open-ephys/ECP5U85-BSE-USB/pcb/images/PXL_20230309_210807720.jpg

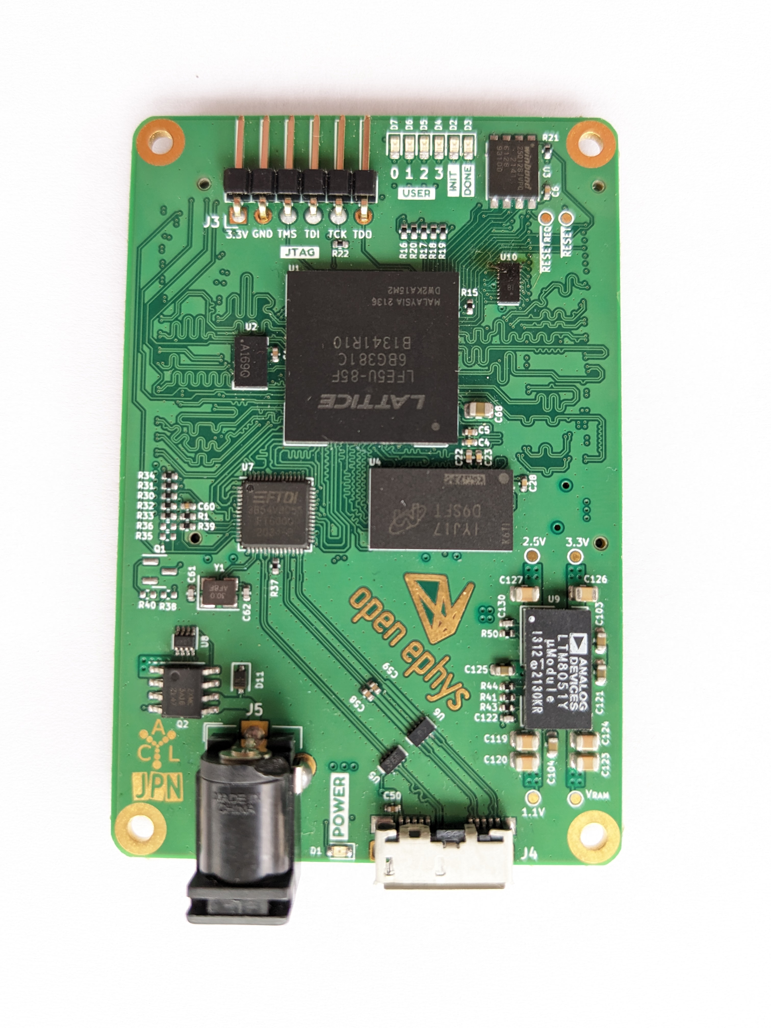
pcb/images/PXL_20230309_210807720.jpg
