open-ephys/ECP5U85-BSE-USB/README.md

# Open Ephys ECP5U85-BSE-USB Development Board

- Lattice ECP5U85 FPGA
- Samtec BSE GPIO strip connectors
- USB3.0 link to host computer (max 200MB/s)

ECP5U85-BSE-USB Rev. A front and back views ECP5U85-BSE-USB Rev. A
