open-ephys/ECP5U85-BSE-USB/pcb/models/PJ-102AH.STEP

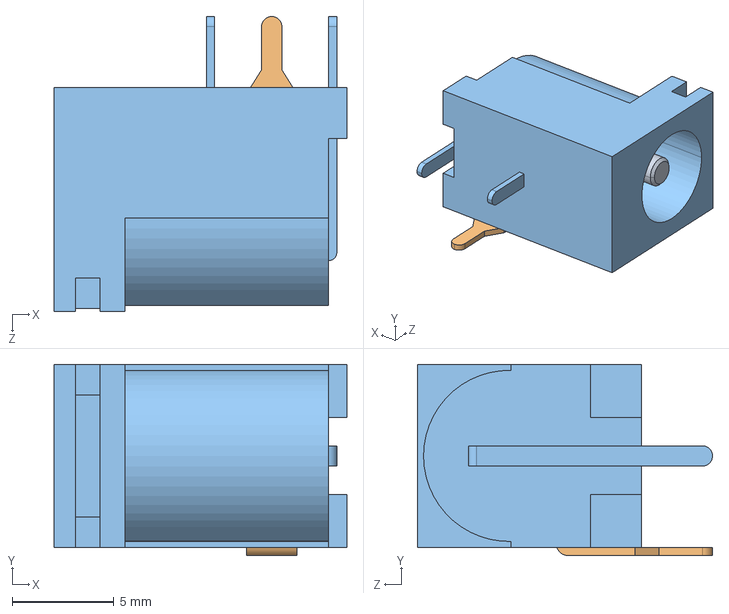
[picture p3: CAD file, 2022-03-02]
pcb/models/PJ-102AH.STEP
14.4 x 9.40 x 14.5 mm
