open-ephys/ECP5U85-BSE-USB/test-pcb/ecp5u85-bse-usb_io-tester.pdf

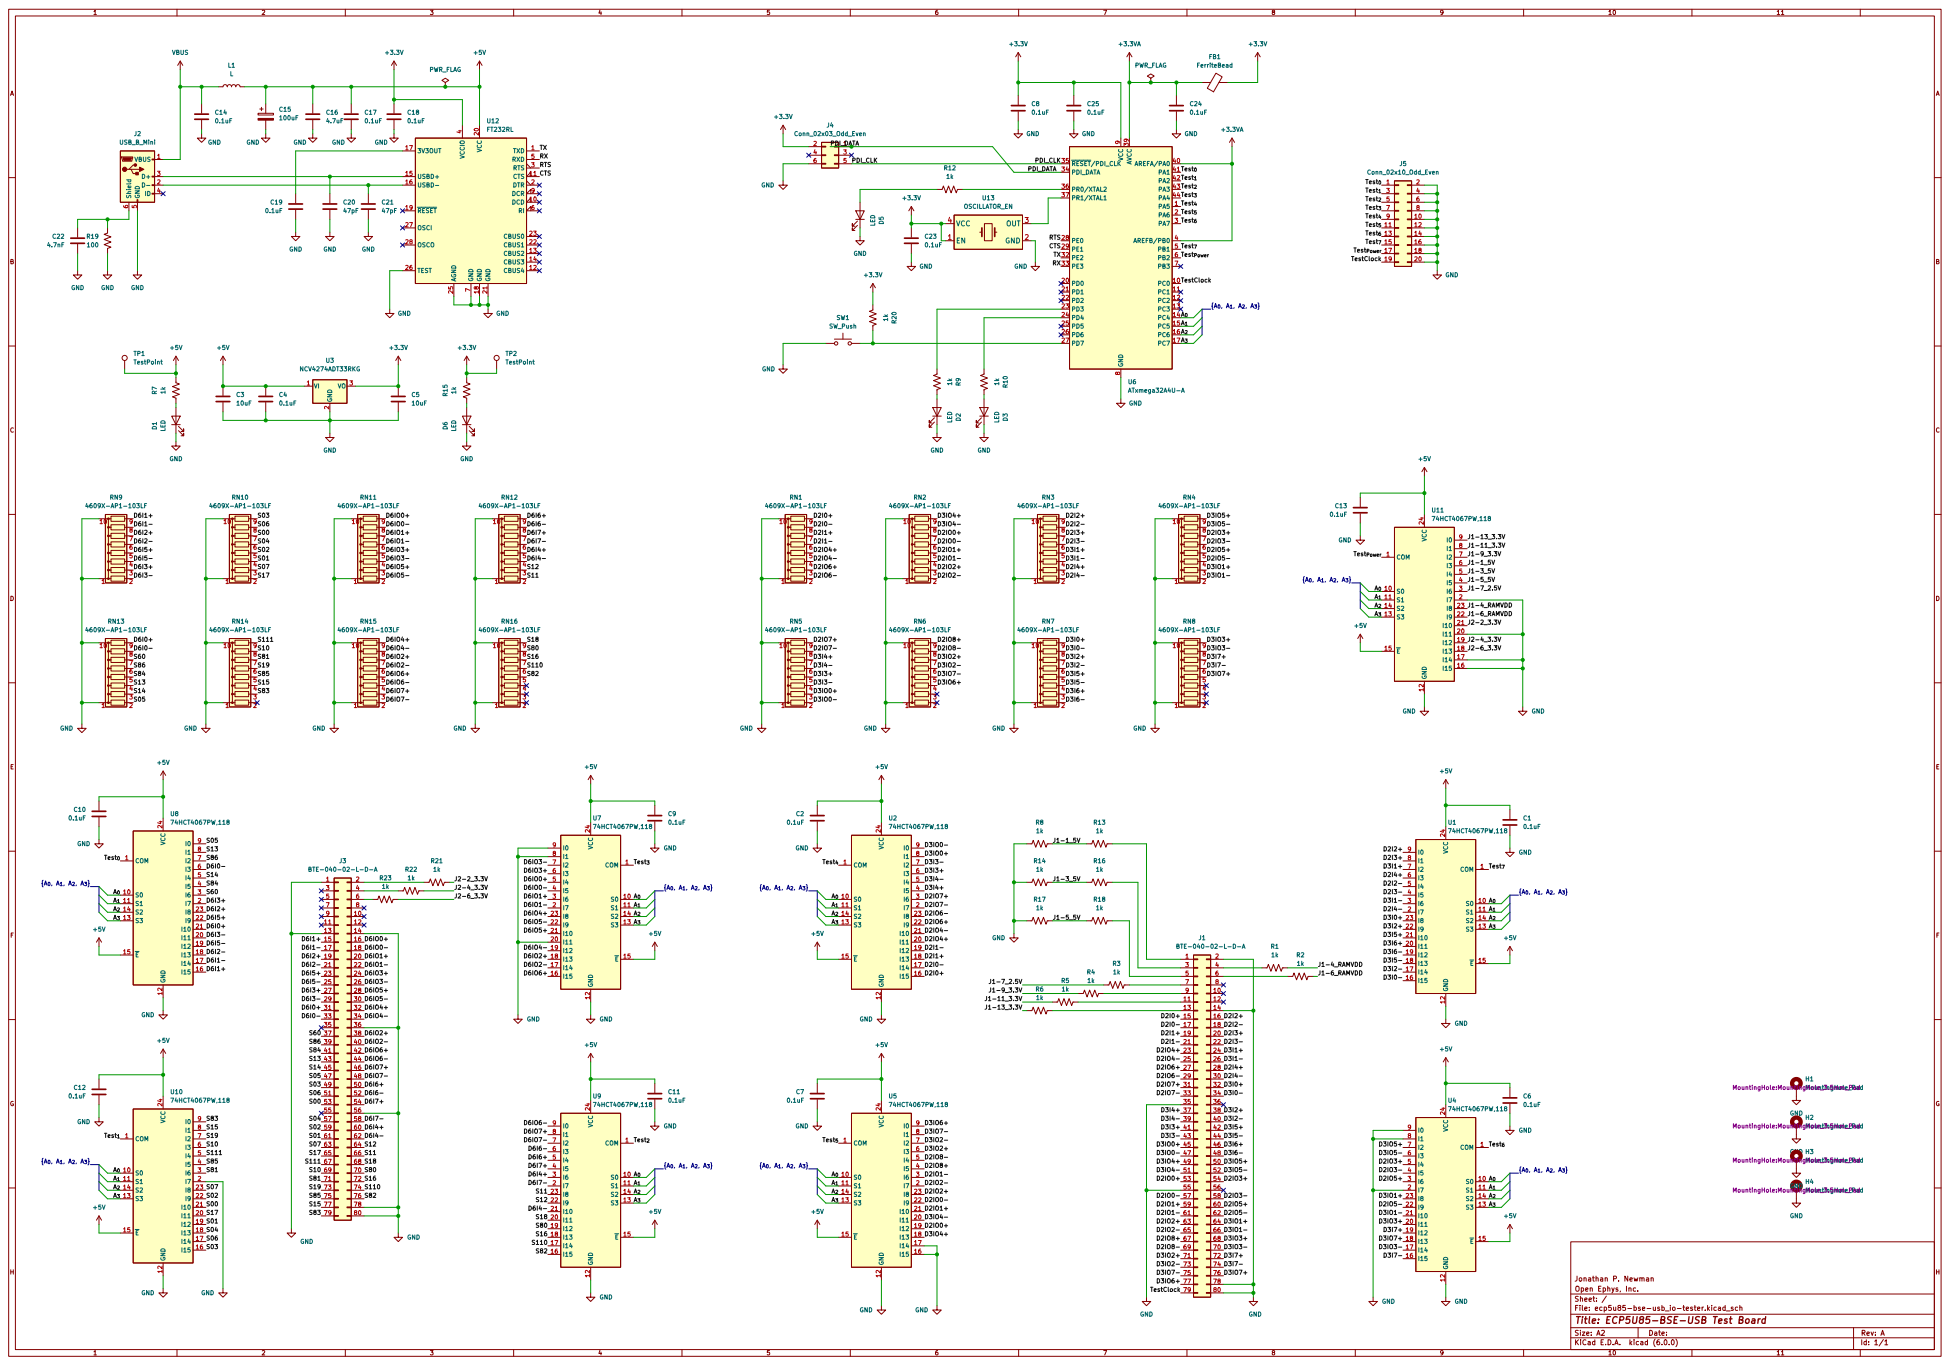
[picture p4: page 1]

RTS
Test_{7} TestClock Test_{Power} RX CTS

File: ecp5u85-bse-usb_io-tester.kicad_sch Sheet: / Open Ephys, Inc. Jonathan P. Newman

Id: 1/1 Title: ECP5U85-BSE-USB Test Board
