open-ephys/ECP5U85-BSE-USB/pcb/ecp5u85-bse-usb.pdf

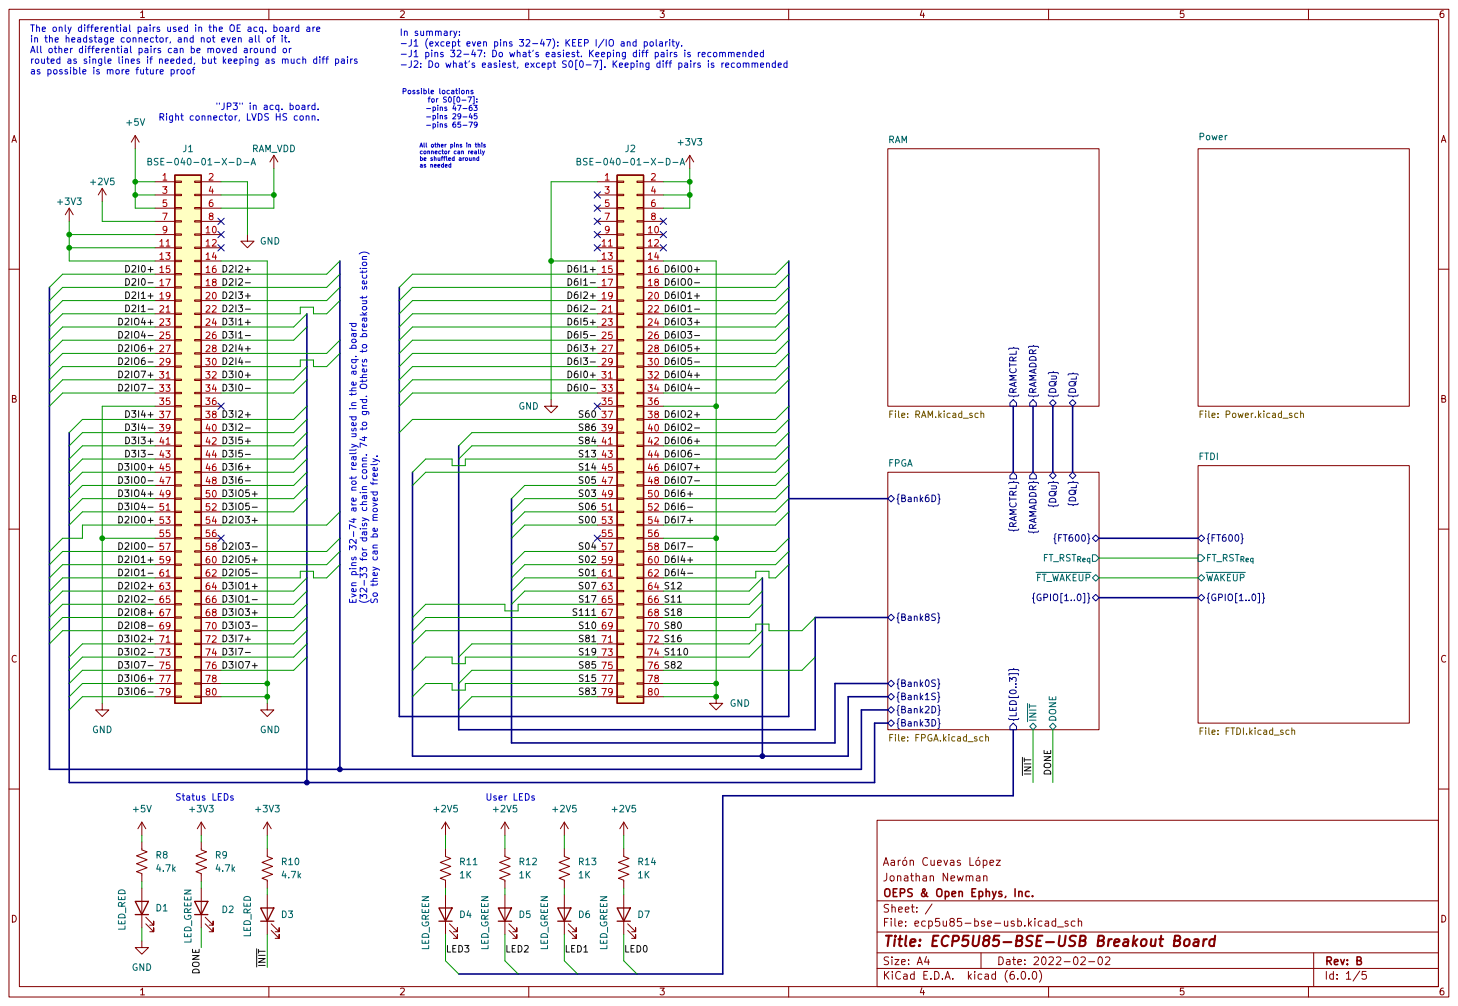
[picture p5: page 1]

The only differential pairs used in the OE acq. board are
in the headstage connector, and not even all of it.
All other differential pairs can be moved around or
routed as single lines if needed, but keeping as much diff pairs
as possible is more future proof

In summary:
-J1 (except even pins 32-47): KEEP I/IO and polarity.
-J1 pins 32-47: Do what's easiest. Keeping diff pairs is recommended
-J2: Do what's easiest, except S0[0-7]. Keeping diff pairs is recommended

All other pins in this

{GPIO[1..0]} FTDI File: FTDI.kicad_sch R9

File: ecp5u85-bse-usb.kicad_sch Sheet: / OEPS & Open Ephys, Inc. Jonathan Newman

Id: 1/5 Title: ECP5U85-BSE-USB Breakout Board

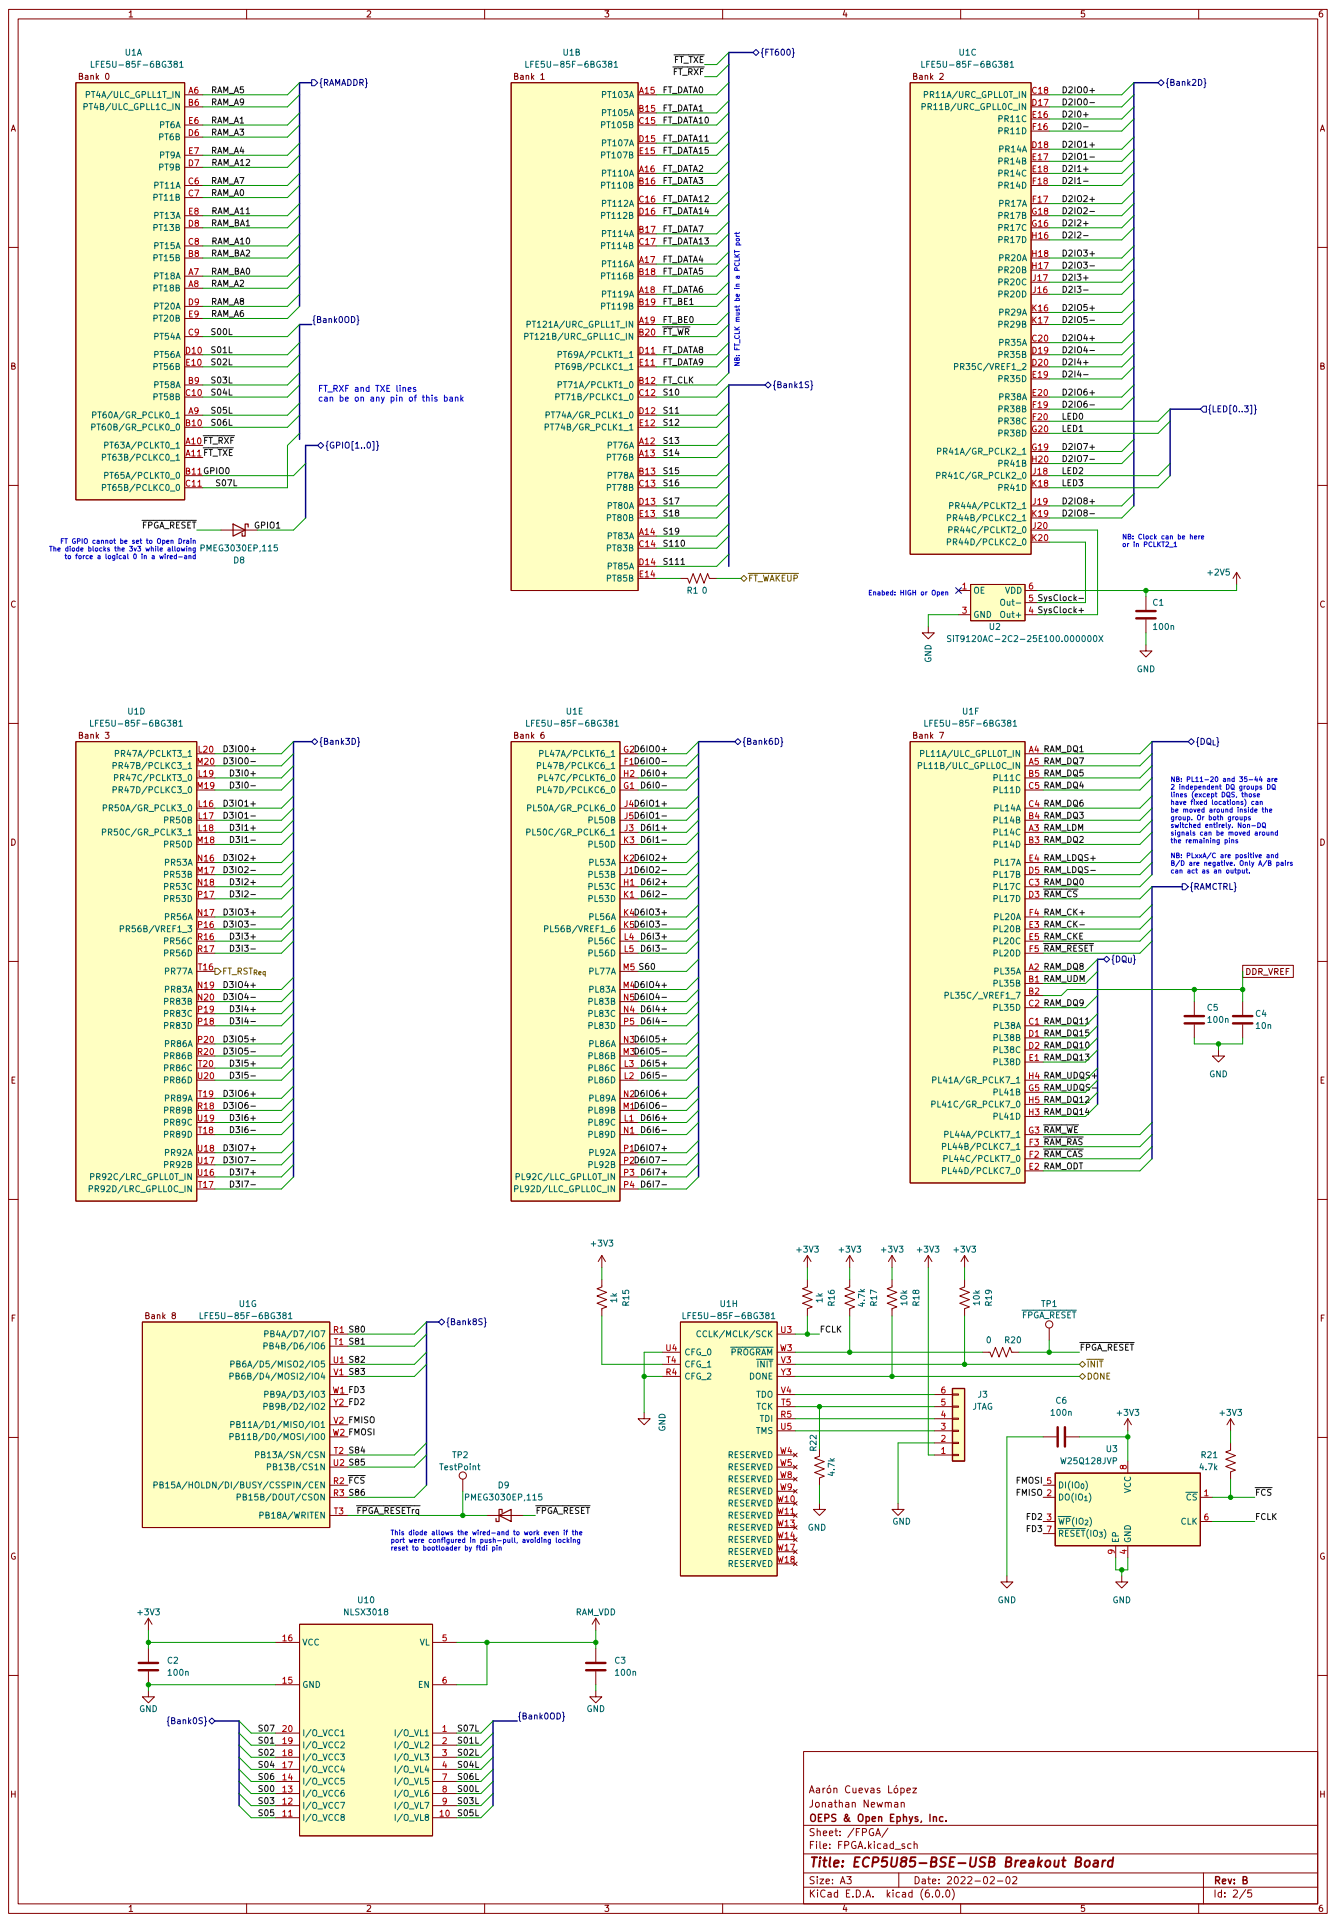
[picture p6: page 2]

Enabed: HIGH or Open FT_RXF and TXE lines
can be on any pin of this bank

or in PCLKT2_1 FT GPIO cannot be set to Open Drain The diode blocks the 3v3 while allowing

NB: Clock can be here

2 independent DQ groups DQ
lines (except DQS, those
have fixed locations) can
be moved around inside the
group. Or both groups
switched entirely. Non-DQ
signals can be moved around
the remaining pins

NB: PLxxA/C are positive and B/D are negative. Only A/B pairs

can act as an output.
{RAMCTRL}

4 DI(IO_{0}) 5 CLK 6 ~{RESET}(IO_{3}) 7 VCC

This diode allows the wired-and to work even if the
port were configured in push-pull, avoiding locking
reset to bootloader by ftdi pin

File: FPGA.kicad_sch Sheet: /FPGA/ OEPS & Open Ephys, Inc. Jonathan Newman

Id: 2/5 Title: ECP5U85-BSE-USB Breakout Board

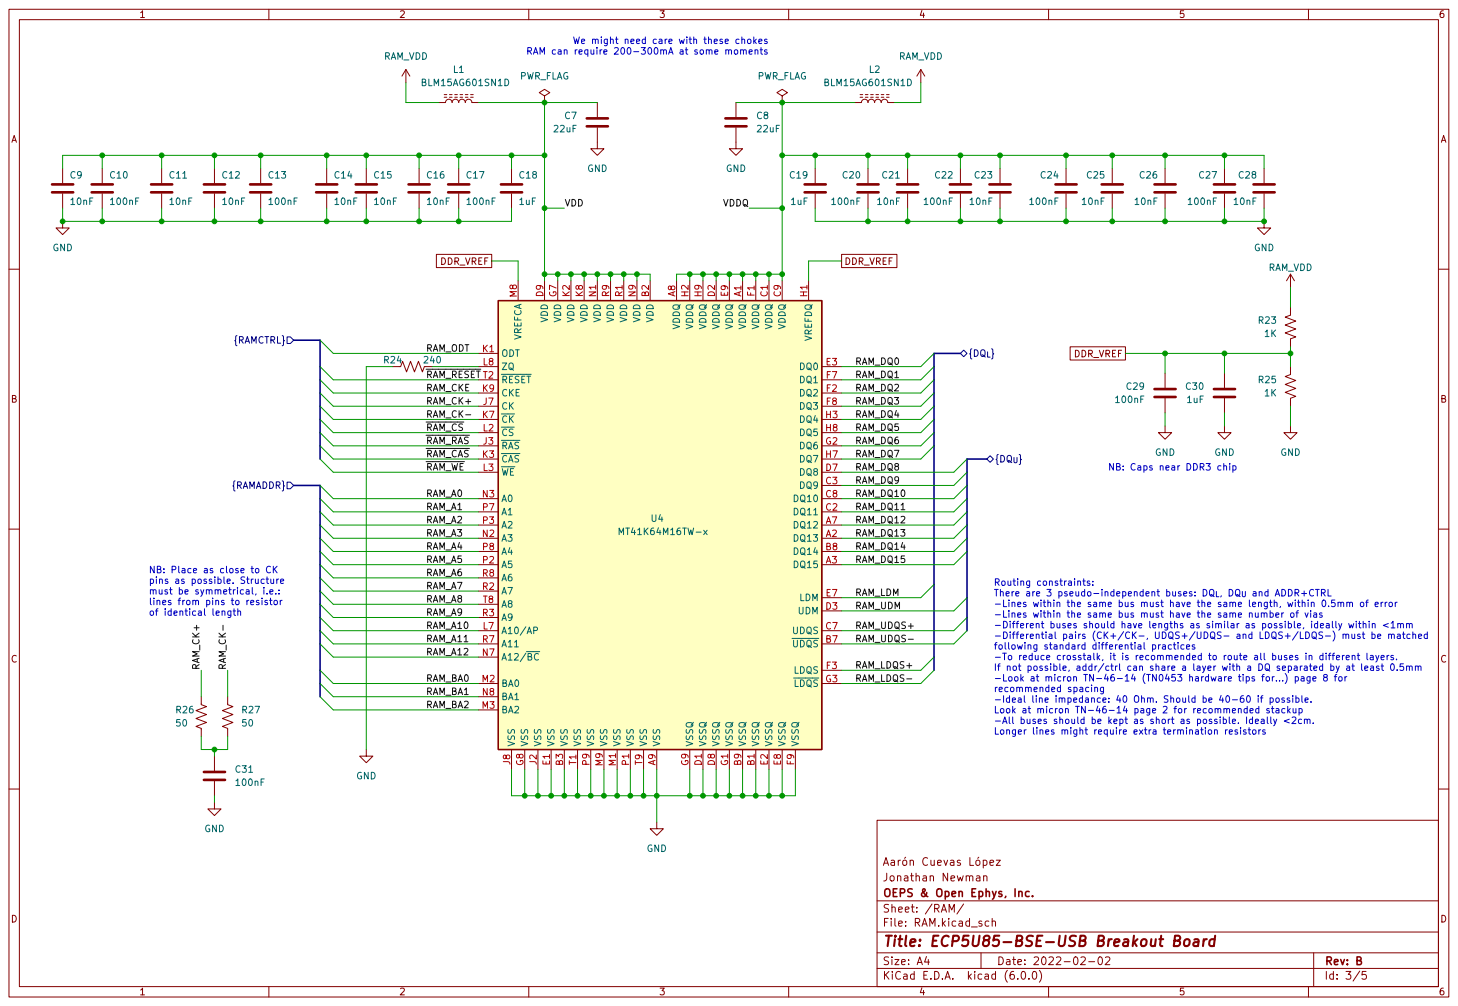
[picture p7: page 3]

RAM can require 200-300mA at some moments NB: Place as close to CK

NB: Caps near DDR3 chip

pins as possible. Structure
must be symmetrical, i.e.:
lines from pins to resistor
of identical length

Routing constraints:
There are 3 pseudo-independent buses: DQ_{L}, DQ_{U} and ADDR+CTRL
-Lines within the same bus must have the same length, within 0.5mm of error
-Lines within the same bus must have the same number of vias
-Different buses should have lengths as similar as possible, ideally within <1mm
-Differential pairs (CK+/CK-, UDQS+/UDQS- and LDQS+/LDQS-) must be matched
following standard differential practices
-To reduce crosstalk, it is recommended to route all buses in different layers.
If not possible, addr/ctrl can share a layer with a DQ separated by at least 0.5mm
-Look at micron TN-46-14 (TN0453 hardware tips for...) page 8 for
recommended spacing
-Ideal line impedance: 40 Ohm. Should be 40-60 if possible.
Look at micron TN-46-14 page 2 for recommended stackup
-All buses should be kept as short as possible. Ideally <2cm.
Longer lines might require extra termination resistors

File: RAM.kicad_sch Sheet: /RAM/ OEPS & Open Ephys, Inc. Jonathan Newman

Id: 3/5 Title: ECP5U85-BSE-USB Breakout Board

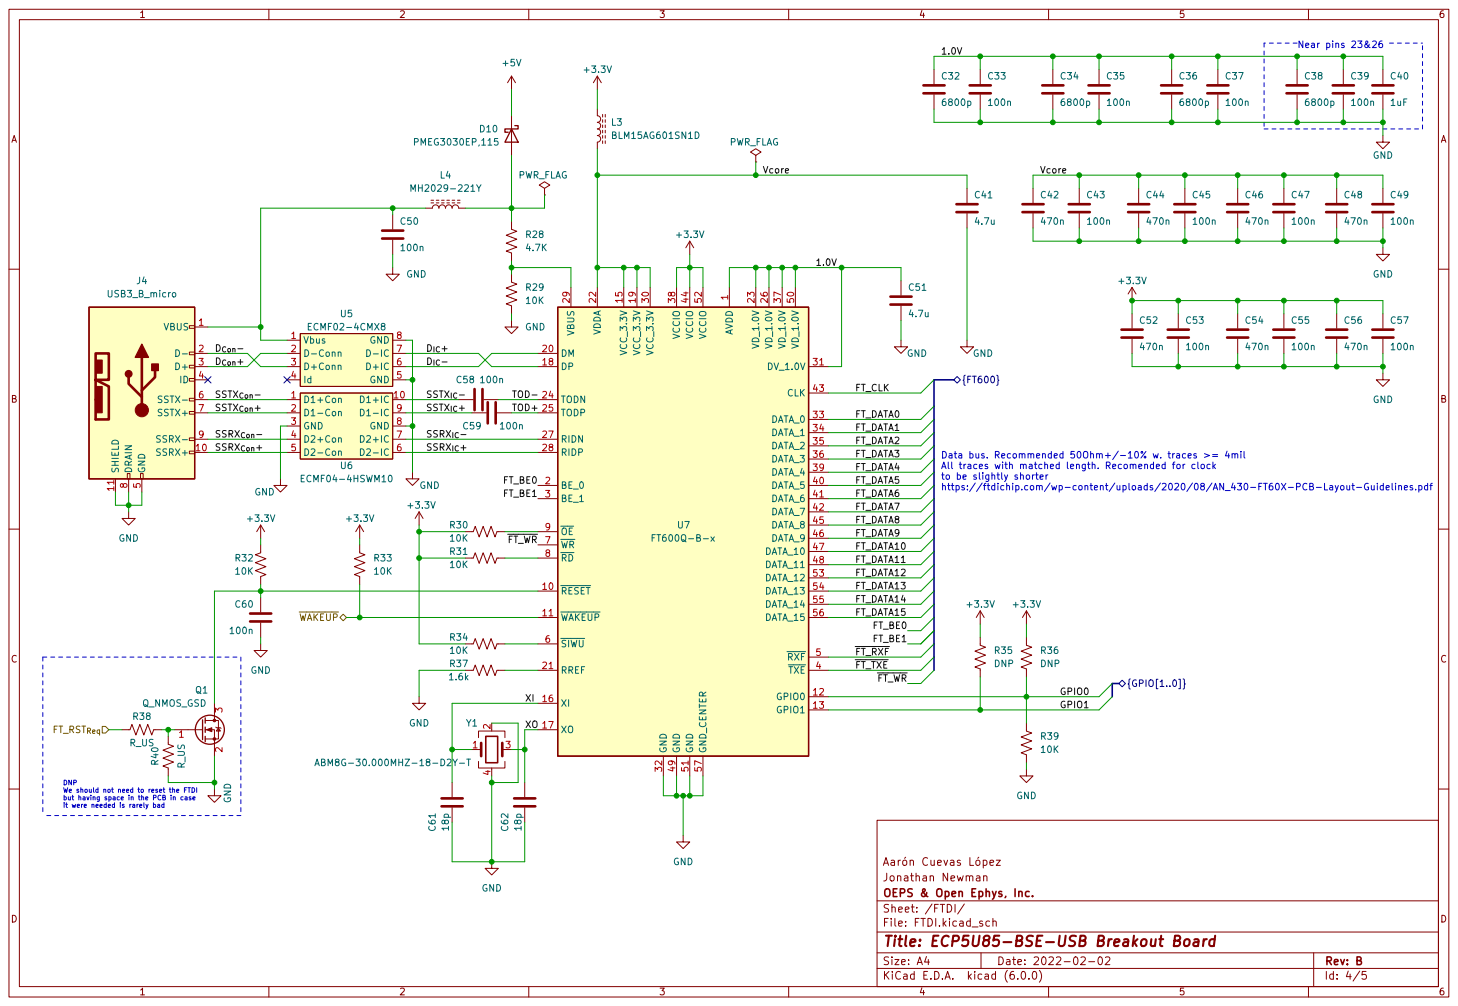
[picture p8: page 4]

Near pins 23&26 Data bus. Recommended 50Ohm+/-10% w. traces >= 4mil All traces with matched length. Recomended for clock
100n GND

1 ~{RESET} 10 ~{WAKEUP} 11 GPIO0 12 GPIO1 13 VCC_3.3V 15 XI 16 XO 17 DP 18 VCC_3.3V 19 BE_0 2 DM 20 RREF 21 VDDA 22 VD_1.0V 23 TODN 24 TODP 25 VD_1.0V 26 RIDN 27 RIDP 28 VBUS 29 BE_1 3 VCC_3.3V 30 DV_1.0V 31 GND 32 DATA_0 33 DATA_1 34 DATA_2 35 DATA_3 36 VD_1.0V 37 VCCIO 38 DATA_4 39 ~{TXE} 4 DATA_5 40 DATA_6 41 DATA_7 42 CLK 43 DATA_8 45 DATA_9 46 DATA_10 47 DATA_11 48 GND 49

to be slightly shorter
https://ftdichip.com/wp-content/uploads/2020/08/AN_430-FT60X-PCB-Layout-Guidelines.pdf

DNP We should not need to reset the FTDI but having space in the PCB in case

it were needed is rarely bad

File: FTDI.kicad_sch Sheet: /FTDI/ OEPS & Open Ephys, Inc. Jonathan Newman

Id: 4/5 Title: ECP5U85-BSE-USB Breakout Board

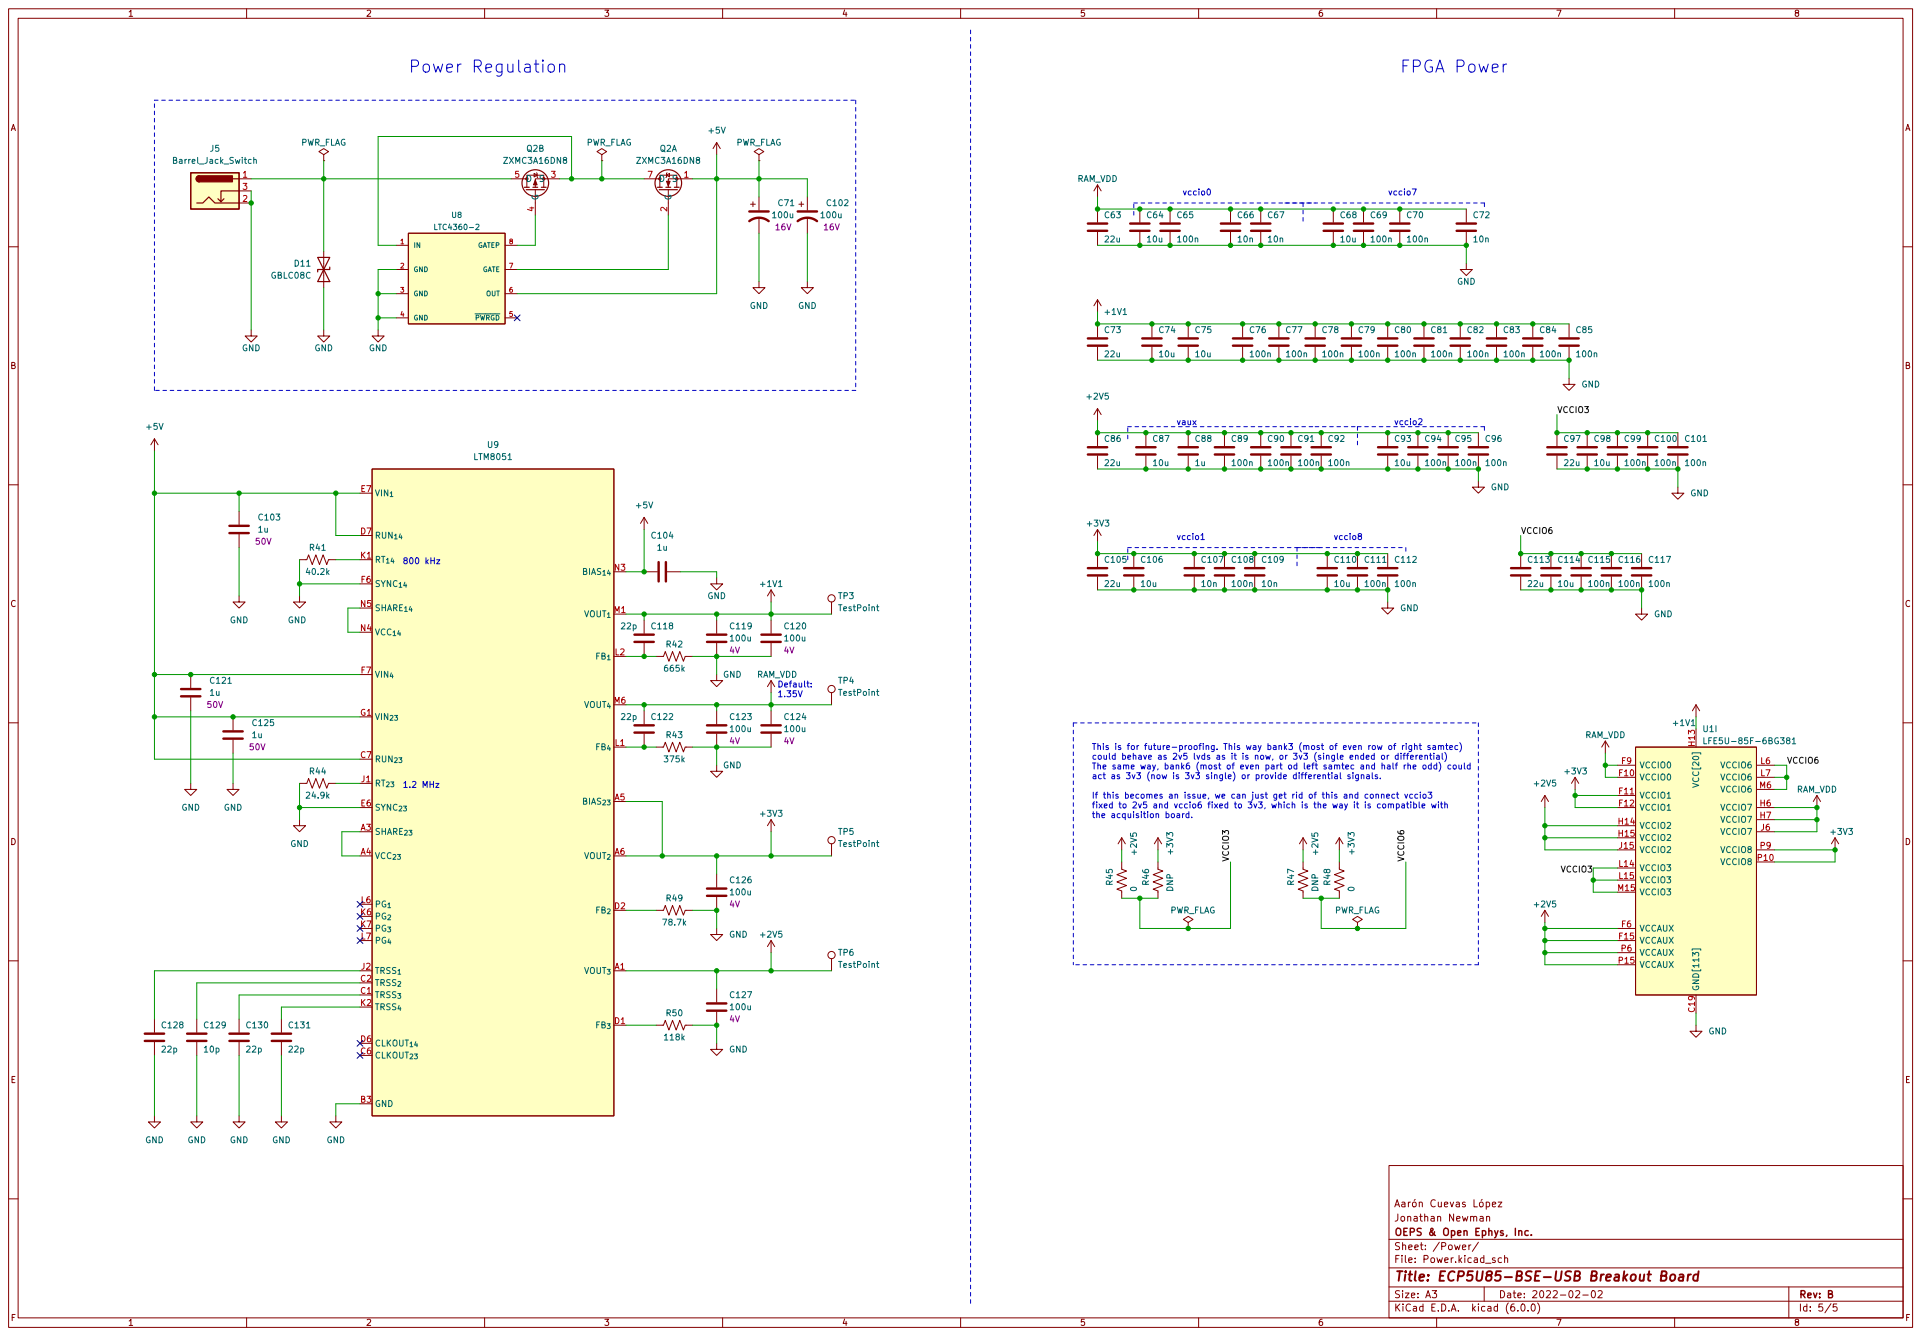
[picture p9: page 5]

vccio1 This is for future-proofing. This way bank3 (most of even row of right samtec)

could behave as 2v5 lvds as it is now, or 3v3 (single ended or differential)
The same way, bank6 (most of even part od left samtec and half rhe odd) could
act as 3v3 (now is 3v3 single) or provide differential signals.
If this becomes an issue, we can just get rid of this and connect vccio3
fixed to 2v5 and vccio6 fixed to 3v3, which is the way it is compatible with
the acquisition board.

File: Power.kicad_sch Sheet: /Power/ OEPS & Open Ephys, Inc. Jonathan Newman

Id: 5/5 Title: ECP5U85-BSE-USB Breakout Board
