open-ephys/ECP5U85-BSE-USB/(commit log)

2022-02-02 First commit of the schematic
    [FPGA.kicad_sch, FTDI.kicad_sch, Power.kicad_sch, RAM.kicad_sch, ecp5u85-bse-usb.kicad_pcb, ecp5u85-bse-usb.kicad_sch]
2022-02-03 Fix some ERC errors
    [FPGA.kicad_sch, FTDI.kicad_sch, Power.kicad_sch, RAM.kicad_sch, ecp5u85-bse-usb.kicad_sch]
2022-02-03 Add extra diode and update TODO
    [FPGA.kicad_sch, ecp5u85-bse-usb.kicad_sch]
2022-02-03 Add filter and ESD protection to USB inputs
    [FTDI.kicad_sch, Power.kicad_sch, ecp5u85-bse-usb.kicad_sch]
2022-02-03 Conect FT_WAKEUP and move FT_RESET to an optional circuit
    [FPGA.kicad_sch, FTDI.kicad_sch, Power.kicad_sch, RAM.kicad_sch, ecp5u85-bse-usb.kicad_sch]
2022-02-07 Fix some symbols
    [FPGA.kicad_sch, FTDI.kicad_sch, Power.kicad_sch, RAM.kicad_sch, ecp5u85-bse-usb.kicad_sch]
2022-02-09 Add FPGA oscillator
    [FPGA.kicad_sch, FTDI.kicad_sch, Power.kicad_sch, RAM.kicad_sch, ecp5u85-bse-usb.kicad_sch]
2022-02-09 Update libraries
    [FTDI.kicad_sch, RAM.kicad_sch, ecp5u85-bse-usb.kicad_sch]
2022-02-09 Add file to generate constraints file based on schematic
2022-02-10 Fix some standards in constraints script
    [gen_constr.py]
2022-02-10 Some net fixes
    [FPGA.kicad_sch, Power.kicad_sch, RAM.kicad_sch]
2022-02-11 Some extra fixes and notes
    [FPGA.kicad_sch, Power.kicad_sch, RAM.kicad_sch, ecp5u85-bse-usb.kicad_sch]
2022-02-14 Rename RAM nets to include prefix
    [FPGA.kicad_sch, RAM.kicad_sch]
2022-02-14 Rename FTDI nets to include prefix
    [FPGA.kicad_sch, FTDI.kicad_sch]
2022-02-25 Initial footprint assignment
    - Some edits to the schematic to improve readability
    [FPGA.kicad_sch, FTDI.kicad_sch, Power.kicad_sch, RAM.kicad_sch, ecp5u85-bse-usb.kicad_sch]
2022-03-02 Rough PCB component placement
    - This will change
    [FPGA.kicad_sch, FTDI.kicad_sch, PJ-102AH.STEP, Power.kicad_sch, RAM.kicad_sch, ecp5u85-bse-usb.kicad_pcb, ecp5u85-bse-usb.kicad_sch]
2022-03-10 Performed rough RAM routing
    - Traces 25 mm long, all matched.
    - No power routed yet but I want to confirm that FPGA pin remap before
    going forward because I can probably make this work.
    [FPGA.kicad_sch, FTDI.kicad_sch, Power.kicad_sch, RAM.kicad_sch, ecp5u85-bse-usb.kicad_pcb, ecp5u85-bse-usb.kicad_sch]
2022-03-10 Return RAM UDQS signals to dedicated FPGA pin
    - J1.2 moved to ground instead of RAM_VDD
    [FPGA.kicad_sch, ecp5u85-bse-usb.kicad_pcb, ecp5u85-bse-usb.kicad_sch]
2022-03-11 Rearrange SAMTEC buses
    [FPGA.kicad_sch, FTDI.kicad_sch, Power.kicad_sch, RAM.kicad_sch, ecp5u85-bse-usb.kicad_sch]
2022-03-11 FTDI FIFO bus to FPGA routing
    - Needs FPGA pin review
    [FPGA.kicad_sch, FTDI.kicad_sch, Power.kicad_sch, RAM.kicad_sch, ecp5u85-bse-usb.kicad_sch]
2022-03-11 Correct hardcoded FTDI lines
    [FPGA.kicad_sch]
2022-03-15 FPGA is broken out
    - Side connectors will need some pin swaps
    - The RAM and FTDI buses need to be retuned because they got moved
    around during this process
    [FPGA.kicad_sch, ecp5u85-bse-usb.kicad_sch]
2022-03-18 Finished IO pin swaping and most of routing
    - Left connector is done, includeing trace tuning
    - Right conenctor is layed out but needs length tuning
    - Decided to move FTDI closer to FPGA and I'm in the middle of that
    [FPGA.kicad_sch, Power.kicad_sch, RAM.kicad_sch, ecp5u85-bse-usb.kicad_sch]
2022-03-22 Most of power routing
    - Will need to retune the lengths again as final step, but only after
    power is complete
    [FPGA.kicad_sch, Power.kicad_sch, RAM.kicad_sch, ecp5u85-bse-usb.kicad_sch]
2022-03-22 Initial routing complete
    - Next is DRC, test-point addition, and aesthetic stuff
    [FPGA.kicad_sch]
2022-03-23 Layout complete pending group review
    - Added preliminary BOM as well to get that process started
    [FPGA.kicad_sch, ecp5u85-bse-usb.kicad_sch]
2022-03-24 Rev. A before fab comments
    - Added gerbers, mount positions, etc.
    [FPGA.kicad_sch, FTDI.kicad_sch, Power.kicad_sch, RAM.kicad_sch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]
2022-03-28 Small modifications after Eurocircuits design review
    - Also changed 0402 S diode to the big package used elsewhere on board
    [FPGA.kicad_sch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]
2022-04-21 Small changes following feedback from speedy
    - Trim back copper from edges to 0.6 mm
    - Get rid of some accidental via in pads
    [ecp5u85-bse-usb-B_Mask.gbr, ecp5u85-bse-usb-B_Paste.gbr, ecp5u85-bse-usb-B_Silkscreen.gbr, ecp5u85-bse-usb-Edge_Cuts.gbr, ecp5u85-bse-usb-F_Mask.gbr, ecp5u85-bse-usb-F_Paste.gbr, ecp5u85-bse-usb-F_Silkscreen.gbr, ecp5u85-bse-usb-GND I.gbr]
2022-05-10 Fix typo in R43 (1.35V output selection) value
    [Power.kicad_sch, RAM.kicad_sch, ecp5u85-bse-usb.kicad_sch]
2022-05-12 Started revision B
    - D8 polarity was reversed
    [FPGA.kicad_sch, FTDI.kicad_sch, Power.kicad_sch, RAM.kicad_sch, ecp5u85-bse-usb.kicad_sch]
2022-07-06 Started IO test fixture
    - Feedback on circuit design needed
    [ecp5u85-bse-usb_io-tester.kicad_pcb, ecp5u85-bse-usb_io-tester.kicad_sch]
2022-08-10 Final changes before version B fabrication
    - Reset diode had its polarity flipped
    [FPGA.kicad_sch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]
2022-08-29 Initial completed IO test board
    - Schematic and layout should be finished.
    - Will generate gerbers upon approval
    [ecp5u85-bse-usb_io-tester.kicad_pcb, ecp5u85-bse-usb_io-tester.kicad_sch]
2023-03-09 Add images of the board
    - Update README with images
2023-03-09 Update README to include images of board
